JoseMiguel-NicolasGarcia/Patch_Antenna_Array/Array/Fase1/Temp/clipboard.bmp

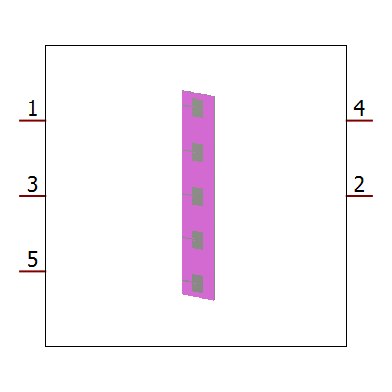
Array/Fase1/Temp/clipboard.bmp
