JoseMiguel-NicolasGarcia/Patch_Antenna_Array/Array/impedancia_puerto.PNG

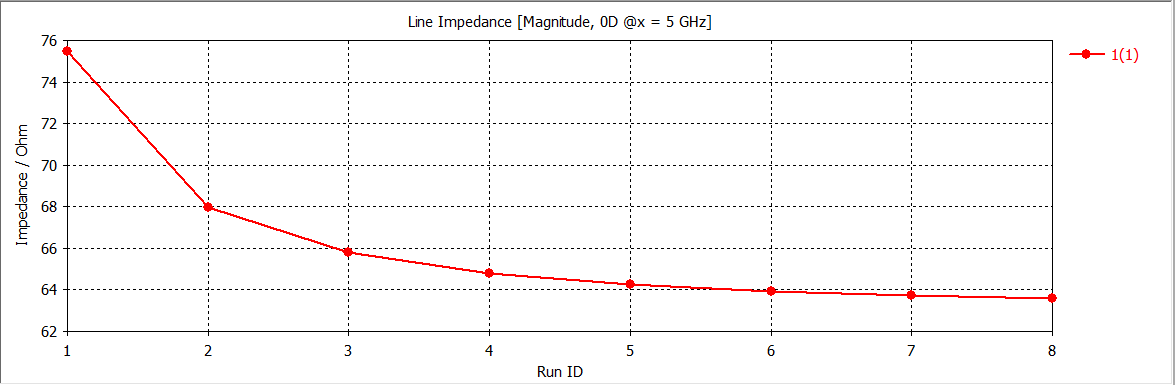
Array/impedancia_puerto.PNG
