JoseMiguel-NicolasGarcia/Patch_Antenna_Array/Fase1/Practica2ConMordisco/Fase1/Temp/clipboard.bmp

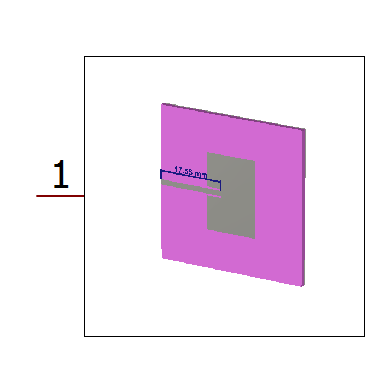
Fase1/Practica2ConMordisco/Fase1/Temp/clipboard.bmp
