JoseMiguel-NicolasGarcia/Patch_Antenna_Array/Fase4.4/Fase1/Temp/clipboard.bmp

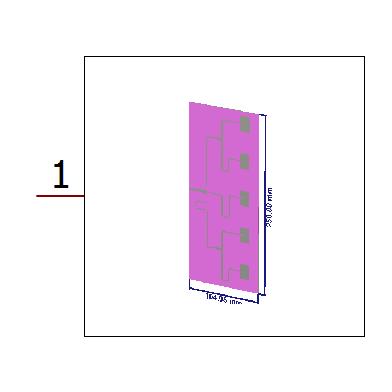
Fase4.4/Fase1/Temp/clipboard.bmp
