JoseMiguel-NicolasGarcia/Patch_Antenna_Array/(list of files, cad)

Other CAD files:
Fase4.4/Fase1/Model/3D/Practica2_Fase3_correccionesMasa_1.dxf
Fase5Taladros/Fase1/Model/3D/Epicidad_maxima_1.dxf
Fase4.4/Fase1/Model/3D/Epicidad_maxima_1.dxf
Fase5Taladros/Fase1/Model/3D/Practica2_Fase3_correccionesMasa_1.dxf
Array/Fase1/ModelCache/Model.psm
Array/Fase1/Result/Port1_e1.prt
Array/Fase1/Result/Port1_e1[5].prt
Array/Fase1/Result/Port1_h1.prt
Array/Fase1/Result/Port1_h1[5].prt
Array/Fase1/Result/Port2_e1.prt
Array/Fase1/Result/Port2_e1[5].prt
Array/Fase1/Result/Port2_h1.prt
Array/Fase1/Result/Port2_h1[5].prt
Array/Fase1/Result/Port3_e1.prt
Array/Fase1/Result/Port3_e1[5].prt
Array/Fase1/Result/Port3_h1.prt
Array/Fase1/Result/Port3_h1[5].prt
Array/Fase1/Result/Port4_e1.prt
Array/Fase1/Result/Port4_e1[5].prt
Array/Fase1/Result/Port4_h1.prt
Array/Fase1/Result/Port4_h1[5].prt
Array/Fase1/Result/Port5_e1.prt
Array/Fase1/Result/Port5_e1[5].prt
Array/Fase1/Result/Port5_h1.prt
Array/Fase1/Result/Port5_h1[5].prt
Array/Fase1/Result/adapt_Port1_e1.prt
Array/Fase1/Result/adapt_Port1_e1[5].prt
Array/Fase1/Result/adapt_Port1_h1.prt
Array/Fase1/Result/adapt_Port1_h1[5].prt
Array/Fase1/Result/adapt_Port2_e1.prt
Array/Fase1/Result/adapt_Port2_e1[5].prt
Array/Fase1/Result/adapt_Port2_h1.prt
Array/Fase1/Result/adapt_Port2_h1[5].prt
Array/Fase1/Result/adapt_Port3_e1.prt
Array/Fase1/Result/adapt_Port3_e1[5].prt
Array/Fase1/Result/adapt_Port3_h1.prt
Array/Fase1/Result/adapt_Port3_h1[5].prt
Array/Fase1/Result/adapt_Port4_e1.prt
Array/Fase1/Result/adapt_Port4_e1[5].prt
Array/Fase1/Result/adapt_Port4_h1.prt
Array/Fase1/Result/adapt_Port4_h1[5].prt
Array/Fase1/Result/adapt_Port5_e1.prt
Array/Fase1/Result/adapt_Port5_e1[5].prt
Array/Fase1/Result/adapt_Port5_h1.prt
Array/Fase1/Result/adapt_Port5_h1[5].prt
ConMordisco_fase2_Ley2/Practica2ConMordisco_Fase2_Ley2/Fase2_Ley2/ModelCache/Model.psm
ConMordisco_fase2_Ley2/Practica2ConMordisco_Fase2_Ley2/Fase2_Ley2/Result/Port1_e1.prt
ConMordisco_fase2_Ley2/Practica2ConMordisco_Fase2_Ley2/Fase2_Ley2/Result/Port1_e1[5].prt
ConMordisco_fase2_Ley2/Practica2ConMordisco_Fase2_Ley2/Fase2_Ley2/Result/Port1_h1.prt
ConMordisco_fase2_Ley2/Practica2ConMordisco_Fase2_Ley2/Fase2_Ley2/Result/Port1_h1[5].prt
ConMordisco_fase2_Ley2/Practica2ConMordisco_Fase2_Ley2/Fase2_Ley2/Result/adapt_Port1_e1.prt
ConMordisco_fase2_Ley2/Practica2ConMordisco_Fase2_Ley2/Fase2_Ley2/Result/adapt_Port1_e1[5].prt
ConMordisco_fase2_Ley2/Practica2ConMordisco_Fase2_Ley2/Fase2_Ley2/Result/adapt_Port1_h1.prt
ConMordisco_fase2_Ley2/Practica2ConMordisco_Fase2_Ley2/Fase2_Ley2/Result/adapt_Port1_h1[5].prt
Fase1/Practica2ConMordisco/Fase1/ModelCache/Model.psm
Fase1/Practica2ConMordisco/Fase1/Result/Port1_e1.prt
Fase1/Practica2ConMordisco/Fase1/Result/Port1_e1[5].prt
Fase1/Practica2ConMordisco/Fase1/Result/Port1_h1.prt
Fase1/Practica2ConMordisco/Fase1/Result/Port1_h1[5].prt
Fase1/Practica2ConMordisco/Fase1/Result/adapt_Port1_e1.prt
Fase1/Practica2ConMordisco/Fase1/Result/adapt_Port1_e1[5].prt
Fase1/Practica2ConMordisco/Fase1/Result/adapt_Port1_h1.prt
Fase1/Practica2ConMordisco/Fase1/Result/adapt_Port1_h1[5].prt
Fase2Ley1/Practica2ConMordiscoConLey1/Practica2ConMordisco/Practica2ConMordisco/Fase1/ModelCache/Model.psm
Fase2Ley1/Practica2ConMordiscoConLey1/Practica2ConMordisco/Practica2ConMordisco/Fase1/Result/Port1_e1.prt
Fase2Ley1/Practica2ConMordiscoConLey1/Practica2ConMordisco/Practica2ConMordisco/Fase1/Result/Port1_e1[5].prt
Fase2Ley1/Practica2ConMordiscoConLey1/Practica2ConMordisco/Practica2ConMordisco/Fase1/Result/Port1_h1.prt
Fase2Ley1/Practica2ConMordiscoConLey1/Practica2ConMordisco/Practica2ConMordisco/Fase1/Result/Port1_h1[5].prt
Fase2Ley1/Practica2ConMordiscoConLey1/Practica2ConMordisco/Practica2ConMordisco/Fase1/Result/adapt_Port1_e1.prt
Fase2Ley1/Practica2ConMordiscoConLey1/Practica2ConMordisco/Practica2ConMordisco/Fase1/Result/adapt_Port1_e1[5].prt
Fase2Ley1/Practica2ConMordiscoConLey1/Practica2ConMordisco/Practica2ConMordisco/Fase1/Result/adapt_Port1_h1.prt
Fase2Ley1/Practica2ConMordiscoConLey1/Practica2ConMordisco/Practica2ConMordisco/Fase1/Result/adapt_Port1_h1[5].prt
Fase4.4/Fase1/ModelCache/Model.psm
Fase4.4/Fase1/Result/Port1_e1.prt
Fase4.4/Fase1/Result/Port1_e1[5].prt
Fase4.4/Fase1/Result/Port1_h1.prt
Fase4.4/Fase1/Result/Port1_h1[5].prt
Fase4.4/Fase1/Result/adapt_Port1_e1.prt
Fase4.4/Fase1/Result/adapt_Port1_e1[5].prt
Fase4.4/Fase1/Result/adapt_Port1_h1.prt
Fase4.4/Fase1/Result/adapt_Port1_h1[5].prt
Fase5Taladros/Fase1/ModelCache/Model.psm
