JoseMiguel-NicolasGarcia/Patch_Antenna_Array/ConMordisco_fase2_Ley2/Practica2ConMordisco_Fase2_Ley2/Fase2_Ley2/Result/FarfieldBkGround.bmp

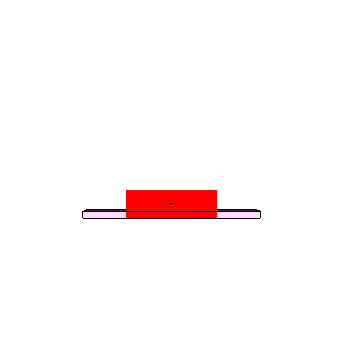
ConMordisco_fase2_Ley2/Practica2ConMordisco_Fase2_Ley2/Fase2_Ley2/Result/FarfieldBkGround.bmp
