JoseMiguel-NicolasGarcia/Patch_Antenna_Array/(list of files, drawings)

Other design files:
Array/Fase1/Model/3D/Model.dsn
Array/Fase1/Model/DS/Model.dsn
ConMordisco_fase2_Ley2/Practica2ConMordisco_Fase2_Ley2/Fase2_Ley2/Model/3D/Model.dsn
ConMordisco_fase2_Ley2/Practica2ConMordisco_Fase2_Ley2/Fase2_Ley2/Model/DS/Model.dsn
Fase1/Practica2ConMordisco/Fase1/Model/3D/Model.dsn
Fase1/Practica2ConMordisco/Fase1/Model/DS/Model.dsn
Fase2Ley1/Practica2ConMordiscoConLey1/Practica2ConMordisco/Practica2ConMordisco/Fase1/Model/3D/Model.dsn
Fase2Ley1/Practica2ConMordiscoConLey1/Practica2ConMordisco/Practica2ConMordisco/Fase1/Model/DS/Model.dsn
Fase4.4/Fase1/Model/3D/Model.dsn
Fase4.4/Fase1/Model/DS/Model.dsn
Fase5Taladros/Fase1/Model/3D/Model.dsn
Fase5Taladros/Fase1/Model/DS/Model.dsn
